yejinee832/braille/docs/demo_scenario.pdf

# 시연 영상 촬영 시나리오

점자 쓰기 학습 시스템 · 시연 모드 (yejinee832.github.io/braille/?demo) · 표 4의 오류 유형 9가지를 모두 보여 주는 순서

### 촬영 전 준비

기기 전원을 켜고(ESP32 빨간 불), 폰의 블루투스·위치(GPS)를 켜 둠
폰 소리 크게, 무음 모드 해제. 기기와 폰 화면이 한 화면에 같이 나오게 배치
시연 페이지를 열 때마다 기록이 비워지고, 화면 아래 "시연한 오류 유형 0/9" 체크가 하나씩 켜짐

### 0. 연결 장면 (첫 장면, 약 20초)

폰 Chrome에서 yejinee832.github.io/braille/?demo를 엶 → 화면 전체가 "화면 아무 곳이나 누르면 기기를 연 결해요"로 바뀜
화면 아무 곳이나 터치 → "기기 목록이 열려요. 목록에는 이 학습기 하나만 보여요…" 음성 → 목록에서 BrailleTrainer → 페어링
"연결됐어요. 이제 기기의 버튼으로 사용할 수 있어요…" 음성 확인
1번 점 → 다음으로 퀴즈 시작 (화면을 만지지 않고 기기로만 시작하는 모습을 보여 주기)
※ 처음 한 번 연결하면 다음부터는 목록 없이 자동으로 다시 연결돼요. 찍다가 끊겨도 "다시 연결하고 있어요" 후 자동 복구돼요.

### 1. 촬영 순서

점은 하나씩 눌러도 모아져요. 틀리면 같은 문제가 다시 나와요. 음성이 끝난 뒤에 다음 입력을 하세요.

문제 | 시 도 | 누를 점 → 버튼 | 오류 유형 | 나오는 음성
1. 첫소리 ㅎ | ① | 다음 1·2·5 | 좌우 반전 | "틀렸어요. 지금 쓴 점자는 ㅌ이에요. 좌우가 바뀌었어요. 1·2·5번이 아니 라 2·4·5번 점이에요."
| ② | 다음 2·4·5 | 정답 | "맞았어요!"
2. 모음 ㅓ | ① | 다음 1·2·6 | 위아래 반전 | "틀렸어요. 지금 쓴 점자는 ㅏ예요. 위 아래가 바뀌었어요. 1·2·6번이 아니 라 2·3·4번 점이에요."
| ② | 다음 2·3·4 | 정답 | "맞았어요!"
3. 받침 ㄱ | ① | 다음 3·5·6 | 다른 글자 | "틀렸어요. 지금 쓴 점자는 받침 ㅎ이 에요. 다른 글자를 썼어요. 받침 ㄱ은 1번 점이에요."
| ② | 다음 4 | 초성·받침 혼동 | "틀렸어요. 지금 쓴 점자는 첫소리 ㄱ 이에요. 첫소리와 받침 자리를 헷갈렸 어요. 받침 ㄱ은 1번 점이에요."
| ③ | 다음 1 | 정답 | "맞았어요!"

4. 약자 나 | ① | 다음 1 | 점 빠짐 | "틀렸어요. 지금 쓴 점자는 받침 ㄱ이 에요. 4번 점을 빠뜨렸어요. 정답은 1·4번 점이에요."
| ② | 다음 1·4·6 | 점 추가 | "틀렸어요. 지금 쓴 점자는 모음 ㅠ예 요. 6번 점을 더 눌렀어요. 정답은 1·4 번 점이에요."
| ③ | 다음 1·4 | 정답 | "맞았어요!"
5. 사과 | ① | 다음 다음 완료 1·2·3 1·2·3·6 | 칸 빠짐 | "틀렸어요. 지금 쓴 단어는 사와예요. 2번째 칸. 첫소리 ㄱ(4번 점) 칸을 빠 뜨렸어요. 정답은 사과예요."
| ② | 다음 다음 다음 완료 1·2·3 4 1·2·3·6 | 정답 | "맞았어요! 사과를 잘 썼어요"
6. 그러나 | ① | 다음 다음 완료 1 2·4 | 점 위치 틀림 | "틀렸어요. 2번째 칸. 지금 쓴 점자는 첫소리 ㄷ이에요. 2번 대신 1번 점이 에요. 정답은 1·4번 점이에요. 정답은 그러나예요."
| ② | 다음 완료 다음 다음 1 1·4 1·4 | 칸 추가 | "틀렸어요. 지금 쓴 단어는 그러나나 예요. 2번째 칸. 필요 없는 칸(첫소리 ㄴ, 1·4번 점)을 더 썼어요. 정답은 그 러나예요."
| ③ | 다음 다음 완료 1 1·4 | 정답 | "맞았어요! 그러나를 잘 썼어요"

### 2. 덧붙이면 좋은 장면 (약 30초)

점 없이 다음 두 번 → 사용법 안내 음성
문제를 듣고 10초 동안 가만히 → "정답을 듣고 싶으면 가운데 지우기 버튼을 두 번 누르세요" 지우기 두 번 → 정답 듣기 (점자 그림으로 정답 표시)
쓴 칸 없이 완료 → 처음 화면 → 나의 기록에서 오류 유형 막대와 베타 분석 리포트 보여 주기

### 3. 촬영 팁

※ 음성에서 자음 이름은 또렷하게 들리도록 끝소리 규칙대로 읽어요 (ㅎ → 히읃, ㅌ → 티읃, ㅋ → 키윽, ㅍ → 피읍, ㅅ → 시옫, ㅈ → 지읃, ㅊ → 치읃).

전체 길이 약 4~5분. 길면 문제 3·4·6에서 틀리는 시도를 하나씩만 남겨도 돼요.

화면의 빨간 글씨(오류 유형)가 보이도록 폰을 기울이지 말고 정면에서 찍으세요.
