yejinee832/braille/docs/images/quiz.png

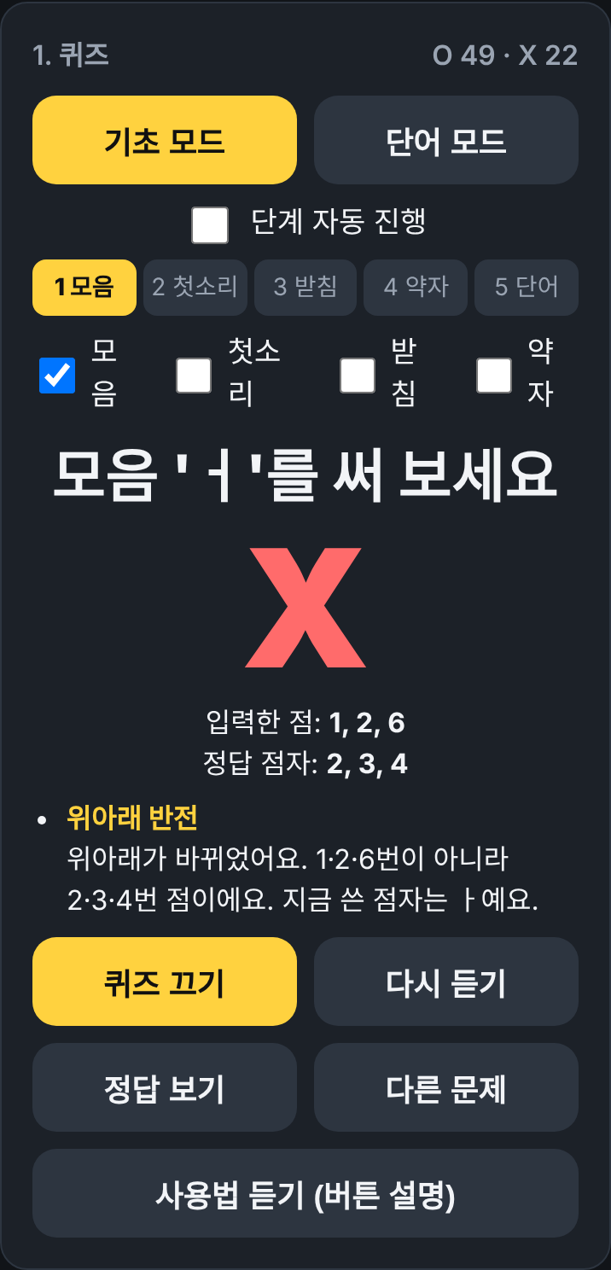
docs/images/quiz.png
