yejinee832/braille/docs/images/stats.png

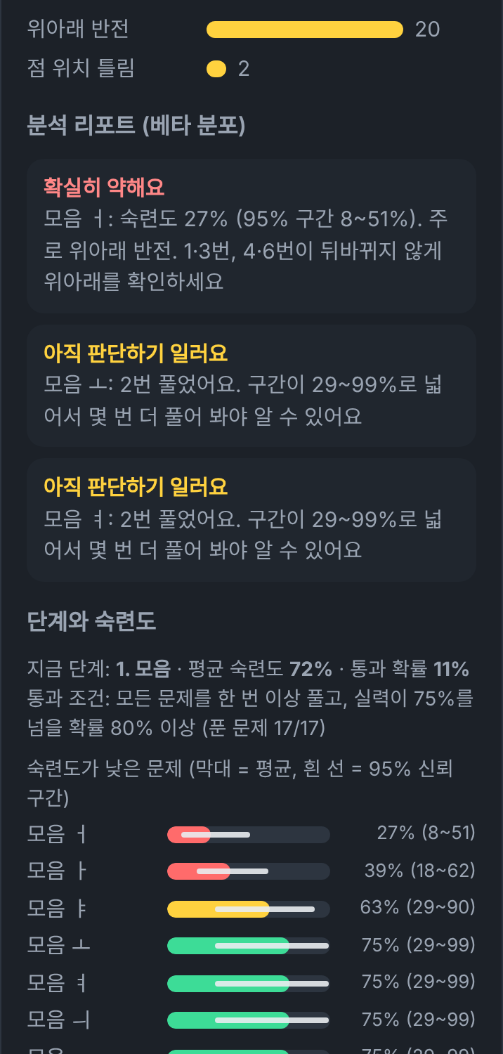
docs/images/stats.png
