yejinee832/braille/docs/images/solder_design.png

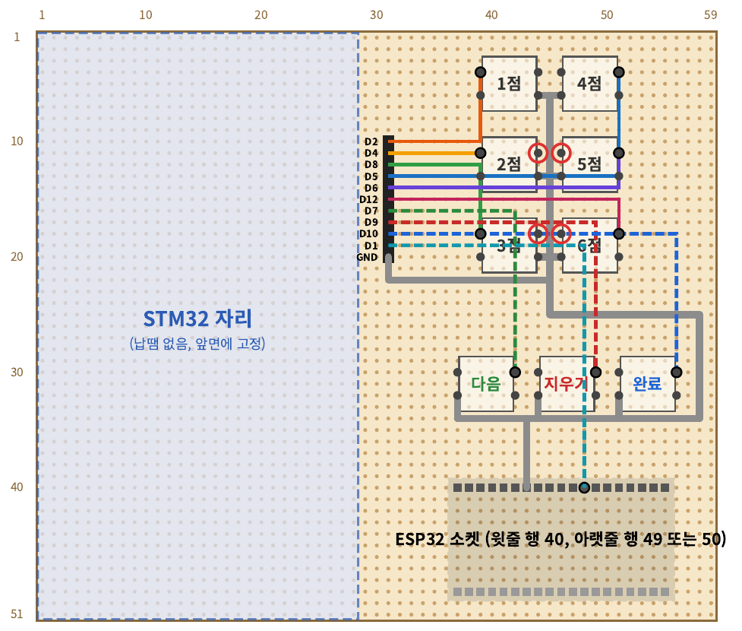
docs/images/solder_design.png
