yejinee832/braille/(commit log)

2026-11-04 빠른 입력 표시 개선, 한 번 누를 때 기록 한 줄
    Claude-Session: https://claude.ai/code/session_012s7wwPE2jwPead3bu4VuJR
2026-11-04 완료 버튼 해석 결과 표시, 모은 점 표시, 20바이트 조각 이어 받기
    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
2026-11-04 지우기·다음 버튼 처리, 쓴 칸과 끝낸 낱말 표시
    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
2026-11-04 완료 시 누른 점과 해석 결과를 음성으로 읽기
    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
2026-11-04 낱말 조합(한국 점자 규칙)과 퀴즈 모드 추가, 다음=칸 확정 / 완료=낱말 끝
    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
2026-11-04 오류 진단(초성·받침 혼동, 좌우·위아래 반전, 점 빠짐·추가, 칸 빠짐·추가), 오류 패턴 통계, 틀린 낱말 자주 다시 내기, 문제 음성 안내
    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
2026-11-04 퀴즈 기초 모드(모음·첫소리·받침 한 칸) / 단어 모드 추가
    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
2026-11-04 퀴즈에 약자(한 칸 글자)와 약어(그래서·그러나…), 약자 낱말 추가
    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
2026-11-04 처음 화면 모드 선택(퀴즈·자유 쓰기·나의 기록), 이전 화면·모드 자유 이동, 퀴즈 이어 풀기, 지우기 두 번 = 정답 보기, 자유 쓰기 '○○ 입니다'
    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
2026-11-05 스크린 리더(TalkBack) 모드: 안내를 aria-live 영역으로 보내 TalkBack이 읽게, 설정 기억
    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
2026-11-05 단계 자동 진행(모음→첫소리→받침→약자→단어), Beta 숙련도 모델·망설임 반영, 학습 기록 저장·날짜별 그래프·CSV 내보내기
    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
2026-11-05 베타 분포 분석: 95% 신뢰구간, 톰슨 샘플링 출제, 통과 확률, 분석 리포트, 파이썬 그래프 스크립트
    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
2026-11-05 정답 음성 멘트를 자연스럽게: '맞았어요! ○○를 잘 썼어요'
    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
2026-11-07 오답 피드백에 '지금 쓴 점자는 ○○예요' 추가, 은/는 조사 수정
    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
2026-11-07 시연 모드(?demo): 정해진 문제를 정해진 순서로 출제, 틀리면 같은 문제 다시, 기록 따로 저장. 문제 문구 조사 수정
    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
2026-11-07 음성이 중간에 끊기지 않게: 문장 단위로 나눠 읽고, 말이 끝난 뒤 다음 문제
    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
2026-11-07 정답을 점자 칸 그림과 '다음 → 완료' 순서로 표시, 음성도 '누르고 다음'으로 안내
    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
2026-11-07 정답 순서 표시에서 '다음 버튼', '완료 버튼'으로 칸과 버튼 구분
    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
2026-11-07 사용법 듣기: 화면 버튼(처음 화면·퀴즈) + 기기에서 점 없이 다음 두 번
    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
2026-11-07 문제를 읽은 뒤 12초 동안 입력이 없으면 정답 듣는 방법 안내 (문제마다 한 번)
    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
2026-11-07 정답 듣기 안내 대기 시간 12초 → 10초
    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
2026-11-07 기초 퀴즈 중에도 쓴 칸 없이 완료를 누르면 처음 화면으로 (모드 바꾸기)
    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
2026-11-07 시연 모드: 오류 유형 체크 표시, 시작 시 기록 초기화, '다른 글자' 조사 수정
    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
2026-11-07 연결 전 전체 화면 터치로 연결, 연결 안내·완료·끊김 음성 안내
    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
2026-11-07 끊기면 목록 없이 자동 재연결, 전에 허락한 기기는 페이지 열 때 자동 연결, 목록 음성 안내
    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
2026-11-07 화면 꺼짐 방지(Wake Lock): 사이트를 보는 동안 폰 화면이 켜져 있게
    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
2026-11-07 저장소 정리: README, 펌웨어(STM32·ESP32), 분석·시뮬레이션 코드, 문서·시연 영상
    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
2026-11-08 README.md 업데이트
2026-11-08 오류 안내 순서 변경(지금 쓴 글자 → 오류 → 정답), 자음 이름을 끝소리 규칙대로 읽기(히읃, 티읃 등)
    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
2026-11-08 시연 시나리오: 바뀐 안내 문장 반영
    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
2026-11-08 음성: 자음 이름 뒤 조사를 떼고 끊어 읽어 또렷하게 (히읃이에요 → 히읃.)
    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
2026-11-08 음성: 자음 이름을 한 글자씩 띄어 읽고(히 읃), 쉼표 대신 마침표로 끊어 끝이 올라가지 않게
    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
2026-11-08 음성: 문제·정답 낱말과 자음 이름은 0.8배 속도로 천천히 (모음 한 글자는 그대로)
    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
